SynKolbasyn/slon/board/esp32_board/dxf/esp32_board-F_Cu.dxf

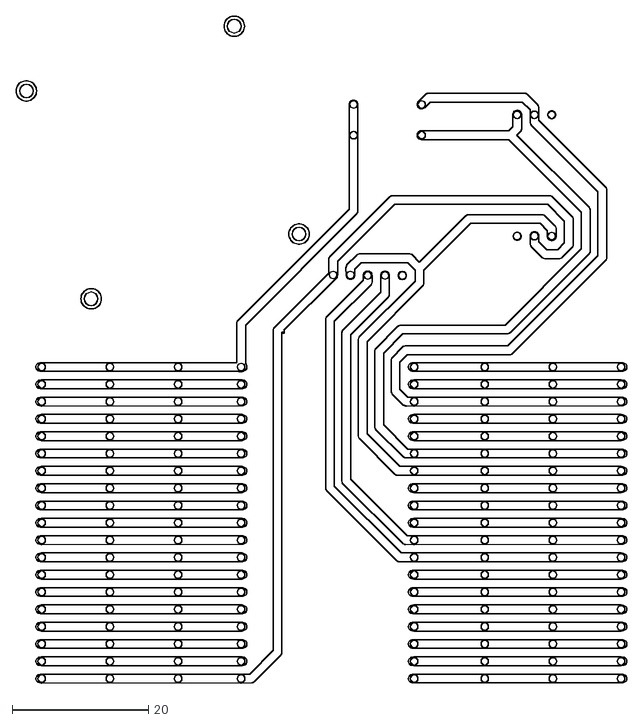
[picture p50: CAD file, 2024-04-10]
board/esp32_board/dxf/esp32_board-F_Cu.dxf
89.6 x 97.9
