SynKolbasyn/slon/board/esp32_board/stl/board.STL

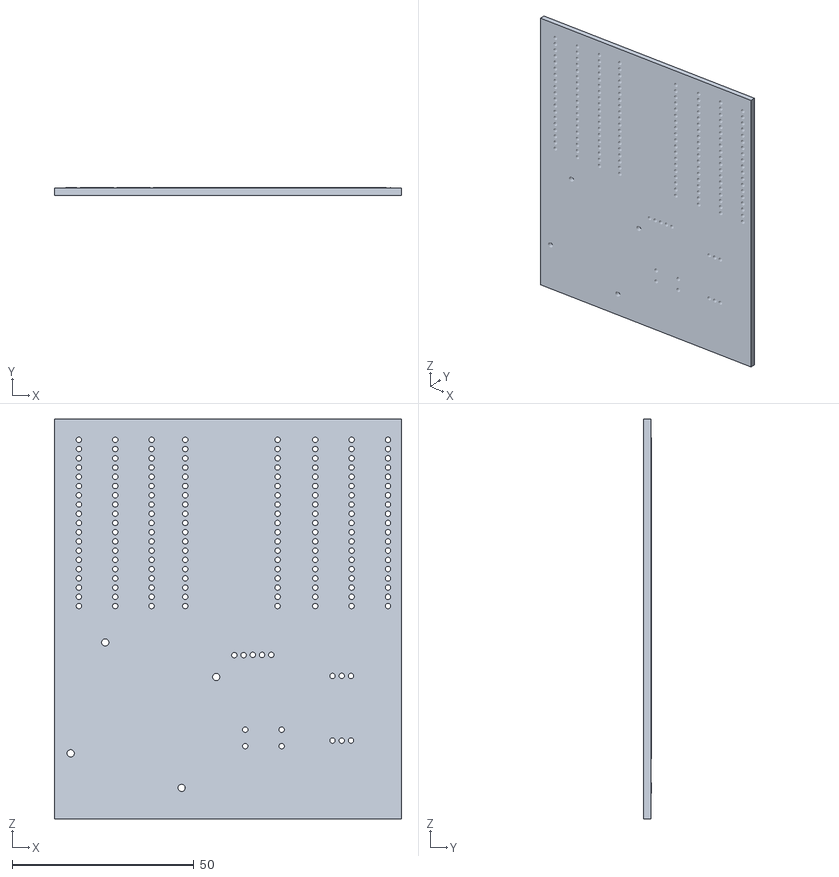
[picture p51: CAD file, 2024-04-10]
board/esp32_board/stl/board.STL
95.5 x 2.10 x 110.0
