SynKolbasyn/slon/docs/struct_scheme.pdf

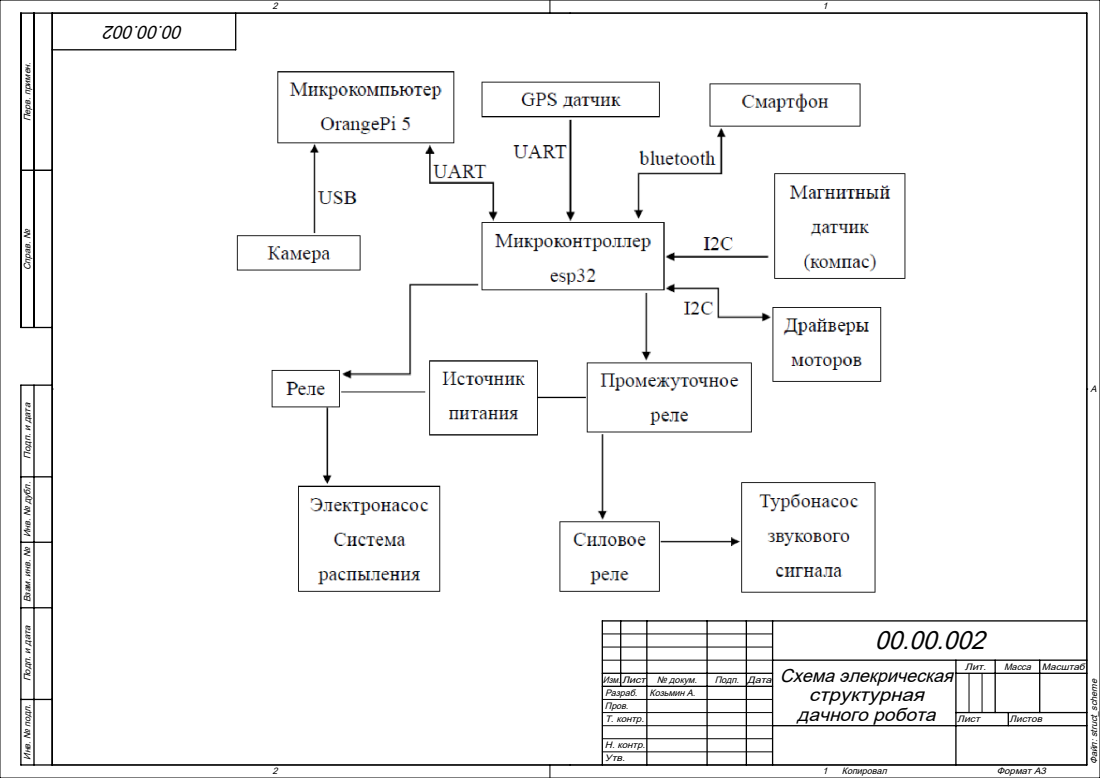
[picture p52: page 1]
Копировал; Формат А3; Файл: struct_scheme

Справ. № Перв. примен. Подп. и дата Инв. № дубл. Взам. инв. № Подп. и дата Инв. № подл.

Схема элекрическая структурная дачного робота | Лит. | Масса | Масштаб

Изм. | Лист № докум. | | Подп. | Дата
Разраб. | | Козьмин А.
Пров.
Т. контр. | | | | | Лист | Листов

Н. контр.
Утв.
