SynKolbasyn/slon/board/esp32_board/esp32_board.kicad_pcb

## KiCad design board/esp32_board/esp32_board.kicad_pcb (2024-04-10)

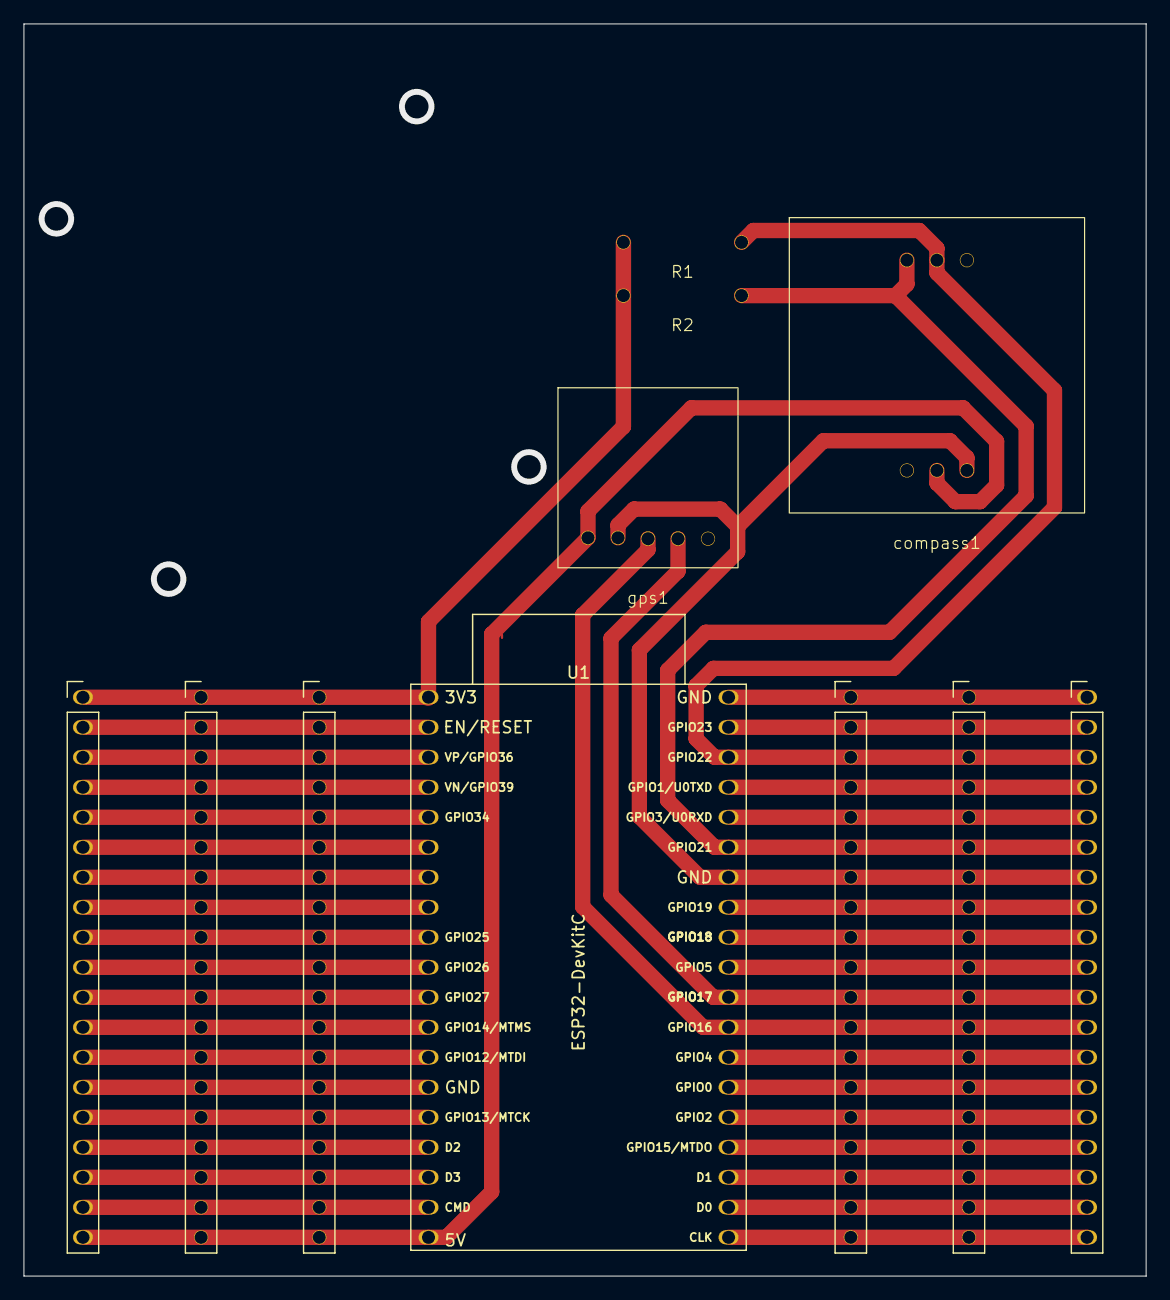
[picture p53: board esp32_board.kicad_pcb from above]

Board: 2 copper layers, 95.0 x 106.0 mm, 11 parts (0 on the bottom side), 36 nets.

Parts:
J1, J2: Screw_Terminal_01x19; PinHeader_1x19_P2.54mm_Vertical
J3, J5: Conn_01x19_Socket; PinHeader_1x19_P2.54mm_Vertical
J4, J6: Conn_01x19_Pin; PinHeader_1x19_P2.54mm_Vertical
R1, R2: 2200; r
U1: ESP32-DevKitC
compass1: compass
gps1: gps

Connections:
0: J1.14, J5.14, J6.14, U1.25 (GPIO0/BOOT/ADC2_CH1)
2: J1.15, J5.15, J6.15, U1.24 (ADC2_CH2/GPIO2)
3V3: J2.1, J3.1, J4.1, R1.1, R2.1, U1.1 (3V3)
4: J1.13, J5.13, J6.13, U1.26 (ADC2_CH0/GPIO4)
5: J1.10, J5.10, J6.10, U1.29 (GPIO5)
12: J2.13, J3.13, J4.13, U1.13 (MTDI/GPIO12/ADC2_CH5)
13: J2.15, J3.15, J4.15, U1.15 (MTCK/GPIO13/ADC2_CH4)
14: J2.12, J3.12, J4.12, U1.12 (MTMS/GPIO14/ADC2_CH6)
15: J1.16, J5.16, J6.16, U1.23 (MTDO/GPIO15/ADC2_CH3)
16: J1.12, J5.12, J6.12, U1.27 (GPIO16), gps1.3 (TX)
17: J1.11, J5.11, J6.11, U1.28 (GPIO17), gps1.4 (RX)
18: J1.9, J5.9, J6.9, U1.30 (GPIO18)
19: J1.8, J5.8, J6.8, U1.31 (GPIO19)
21: J1.6, J5.6, J6.6, R2.2, U1.33 (GPIO21), compass1.4 (D)
22: J1.3, J5.3, J6.3, R1.2, U1.36 (GPIO22), compass1.5 (C)
23: J1.2, J5.2, J6.2, U1.37 (GPIO23)
25: J2.9, J3.9, J4.9, U1.9 (DAC_1/ADC2_CH8/GPIO25)
26: J2.10, J3.10, J4.10, U1.10 (DAC_2/ADC2_CH9/GPIO26)
27: J2.11, J3.11, J4.11, U1.11 (ADC2_CH7/GPIO27)
32: J2.7, J3.7, J4.7, U1.7 (32K_XP/GPIO32/ADC1_CH4)
33: J2.8, J3.8, J4.8, U1.8 (32K_XN/GPIO33/ADC1_CH5)
34: J2.5, J3.5, J4.5, U1.5 (VDET_1/GPIO34/ADC1_CH6)
35: J2.6, J3.6, J4.6, U1.6 (VDET_2/GPIO35/ADC1_CH7)
CLK: J1.19, J5.19, J6.19, U1.20 (SD_CLK/GPIO6)
CMD: J2.18, J3.18, J4.18, U1.18 (CMD)
EN: J2.2, J3.2, J4.2, U1.2 (CHIP_PU)
GND: J1.1, J1.7, J2.14, J3.14, J4.14, J5.1, J5.7, J6.1, J6.7, U1.14 (GND), U1.32 (GND), U1.38 (GND), compass1.3 (G), gps1.2 (GND)
RX: J1.5, J5.5, J6.5, U1.34 (U0RXD/GPIO3)
SD0: J1.18, J5.18, J6.18, U1.21 (SD_DATA0/GPIO7)
SD1: J1.17, J5.17, J6.17, U1.22 (SD_DATA1/GPIO8)
SD2: J2.16, J3.16, J4.16, U1.16 (SD_DATA2/GPIO9)
SD3: J2.17, J3.17, J4.17, U1.17 (SD_DATA3/GPIO10)
SN: J2.4, J3.4, J4.4, U1.4 (SENSOR_VN/GPIO39/ADC1_CH3)
SP: J2.3, J3.3, J4.3, U1.3 (SENSOR_VP/GPIO36/ADC1_CH0)
TX: J1.4, J5.4, J6.4, U1.35 (U0TXD/GPIO1)
V5: J2.19, J3.19, J4.19, U1.19 (5V), compass1.2 (V), gps1.1 (VCC)
