SynKolbasyn/slon/esp32/slon/include/types.h

#pragma once

#ifndef _TYPES_H_
#define _TYPES_H_


namespace sk {


typedef short int i16;
typedef unsigned short int u16;
typedef int i32;
typedef unsigned int u32;
typedef long long i64;
typedef unsigned long long u64;
typedef float f32;
typedef double f64;


} // namespace sk


#endif
