SynKolbasyn/slon/catkin_ws/camera_calibration_data_640_480.yaml

%YAML:1.0
---
calibration_time: "Вт 13 фев 2024 16:37:39"
nr_of_frames: 100
image_width: 640
image_height: 480
board_width: 7
board_height: 6
square_size: 106.
marker_size: 53.
fix_aspect_ratio: 1.
# flags: +fix_aspectRatio +fix_principal_point +zero_tangent_dist +fix_k4 +fix_k5
flags: 6158
fisheye_model: 0
camera_matrix: !!opencv-matrix
   rows: 3
   cols: 3
   dt: d
   data: [ 5.9861987094549465e+02, 0., 3.1950000000000000e+02, 0.,
       5.9861987094549465e+02, 2.3950000000000000e+02, 0., 0., 1. ]
distortion_coefficients: !!opencv-matrix
   rows: 5
   cols: 1
   dt: d
   data: [ -3.5651113377855280e-02, 3.6689850919950107e-01, 0., 0.,
       -8.0554993764294169e-01 ]
avg_reprojection_error: 2.1110807188235454e+00
per_view_reprojection_errors: !!opencv-matrix
   rows: 100
   cols: 1
   dt: f
   data: [ 5.80980241e-01, 5.39924443e-01, 5.68816304e-01,
       5.76711595e-01, 5.73276043e-01, 6.26027167e-01, 5.68677068e-01,
       6.32779241e-01, 6.75362945e-01, 7.83244789e-01, 7.27856338e-01,
       5.67003429e-01, 6.14381492e-01, 5.54933071e-01, 4.95603532e-01,
       4.54049557e-01, 4.97445136e-01, 5.91136754e-01, 4.78490114e-01,
       9.08199728e-01, 9.82330322e-01, 9.91443336e-01, 9.76984620e-01,
       9.43556368e-01, 9.70196307e-01, 9.70366478e-01, 1.06466424e+00,
       1.02702868e+00, 9.59523499e-01, 9.11855817e-01, 1.32165694e+00,
       1.77225721e+00, 1.52769792e+00, 1.35664916e+00, 1.64901447e+00,
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
    530., 318., 0., 636., 318., 0., 0., 424., 0., 106., 424., 0., 212.,
    424., 0., 318., 424., 0., 424., 424., 0., 530., 424., 0., 636., 424.,
    0., 0., 530., 0., 106., 530., 0., 212., 530., 0., 318., 530., 0.,
    424., 530., 0., 530., 530., 0., 636., 530., 0. ]
