SynKolbasyn/slon/(commit log)

2023-09-28 feat(esp): Added Esp32 and simple ros control
2023-09-30 feat(esp): Added tetrix driver library
2023-09-30 fix: Fixed robot control and qr code detection
    [main.cpp]
2023-10-06 feat(android): Added bluetooth devices list and enabling bluetooth
2023-10-09 feat(bt): Added bluetooth to android app and esp32
2023-11-23 fix(bt): Fixed some bugs with bluetooth
    [bluetooth.h, main.cpp]
2023-11-23 fix(proj): Fixed VERY MUTCH BUGS
    [bluetooth.h, compass.h, main.cpp]
2024-02-05 fix: fixed distance recognition
    [camera.cpp, main.cpp]
2024-02-14 added aruco detection
    [camera_calibration_data.yaml]
2024-02-14 feat: small changes
    [camera_calibration_data_640_480.yaml]
2024-02-15 fix: turn on compass
    [compass.h]
2024-02-15 fix: added pins for sprayer and horn
    [AIR_HORN.h, sprayer.h]
2024-02-19 fix: FIXED FATAL ERROR WITH AIR HORN. IT COST ME A CARLOAD OF NERVE CELLS
    [AIR_HORN.h, main.cpp]
2024-02-19 fix: fixed pid regulyator
    [main.cpp]
2024-03-17 feat: Added docs and starting create own board
    [esp32_board.kicad_pcb, esp32_board.kicad_sch]
2024-03-17 feat: Added schematic for board
    [esp32_board.kicad_sch]
2024-03-19 feat: Updated board
    [esp32_board.kicad_sch]
2024-03-20 feat: Updated presentation and board
    [esp32_board.kicad_pcb, esp32_board.kicad_sch]
2024-03-20 feat: Updated board and presentation
    [esp32_board.kicad_pcb, esp32_board.kicad_sch]
2024-03-26 feat(board): Added modules - gps, compass, relay. And builded schematic
    [esp32_board.kicad_sch]
2024-03-26 fix(board): Removed unused files
2024-03-26 feat(docs): Added board schematic into docs
    [esp32_board.kicad_sch]
2024-03-26 feat: Updated docs and board
    [esp32_board.kicad_pcb, esp32_board.kicad_sch]
2024-03-27 feat(board): Added roads
    [esp32_board.kicad_pcb, esp32_board.kicad_sch]
2024-03-28 feat(board): Updated board
    [esp32_board.kicad_pcb]
2024-03-31 feat: Updated docs
    [esp32_board.kicad_sch]
2024-04-10 feat: Final board version and updated docs
    [board.STL, esp32_board-Edge_Cuts.dxf, esp32_board-F_Cu.dxf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]
